jfdoppler/Placa-grabador/guia.pdf

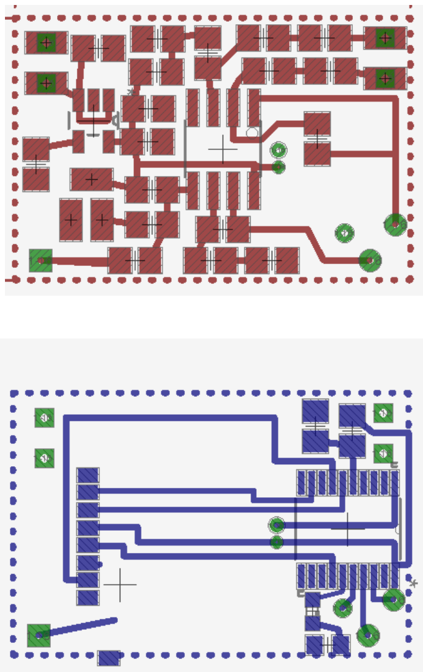
[picture p2: page 1]
