jfdoppler/Placa-grabador/drawing-1.png

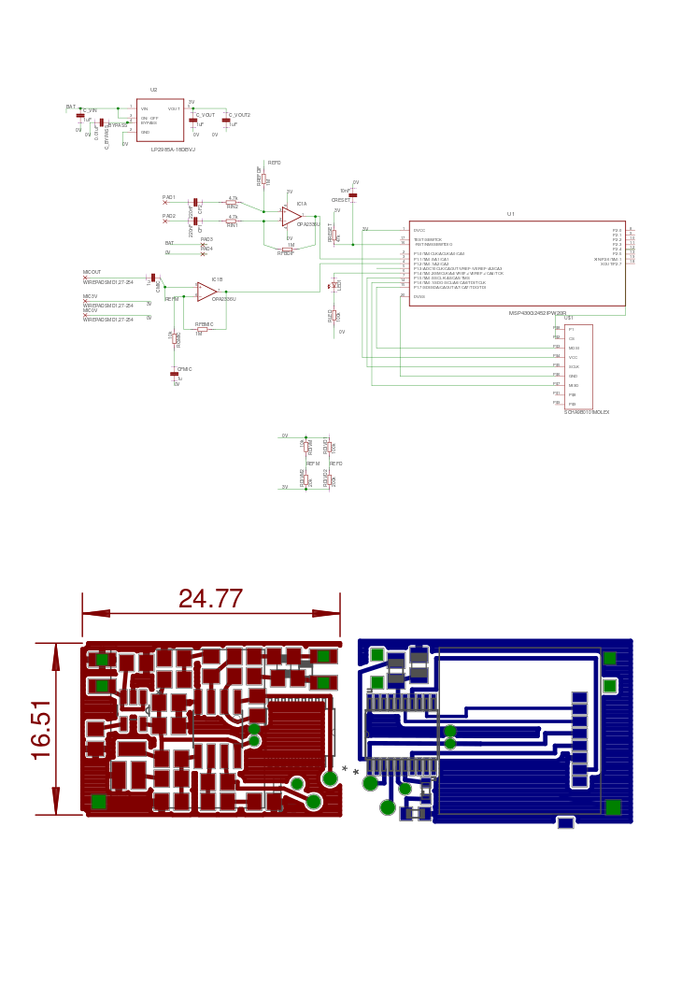
drawing-1.png
