jfdoppler/Placa-grabador/Placa terminada 31082017/20170831_150136.jpg

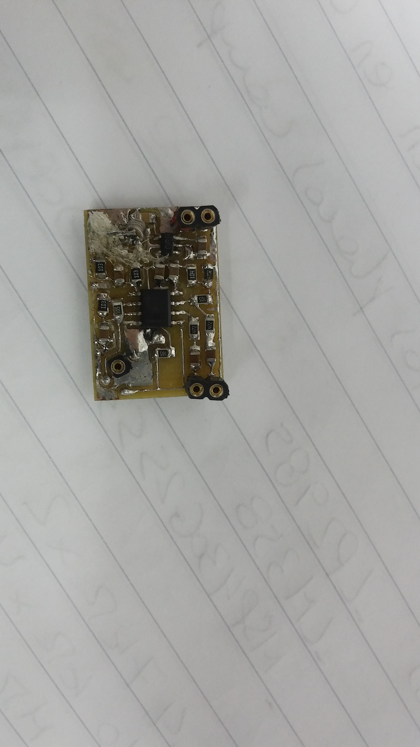
Placa terminada 31082017/20170831_150136.jpg
