jfdoppler/Placa-grabador/v2017.svg.pdf

### OPA2336U

4.7k

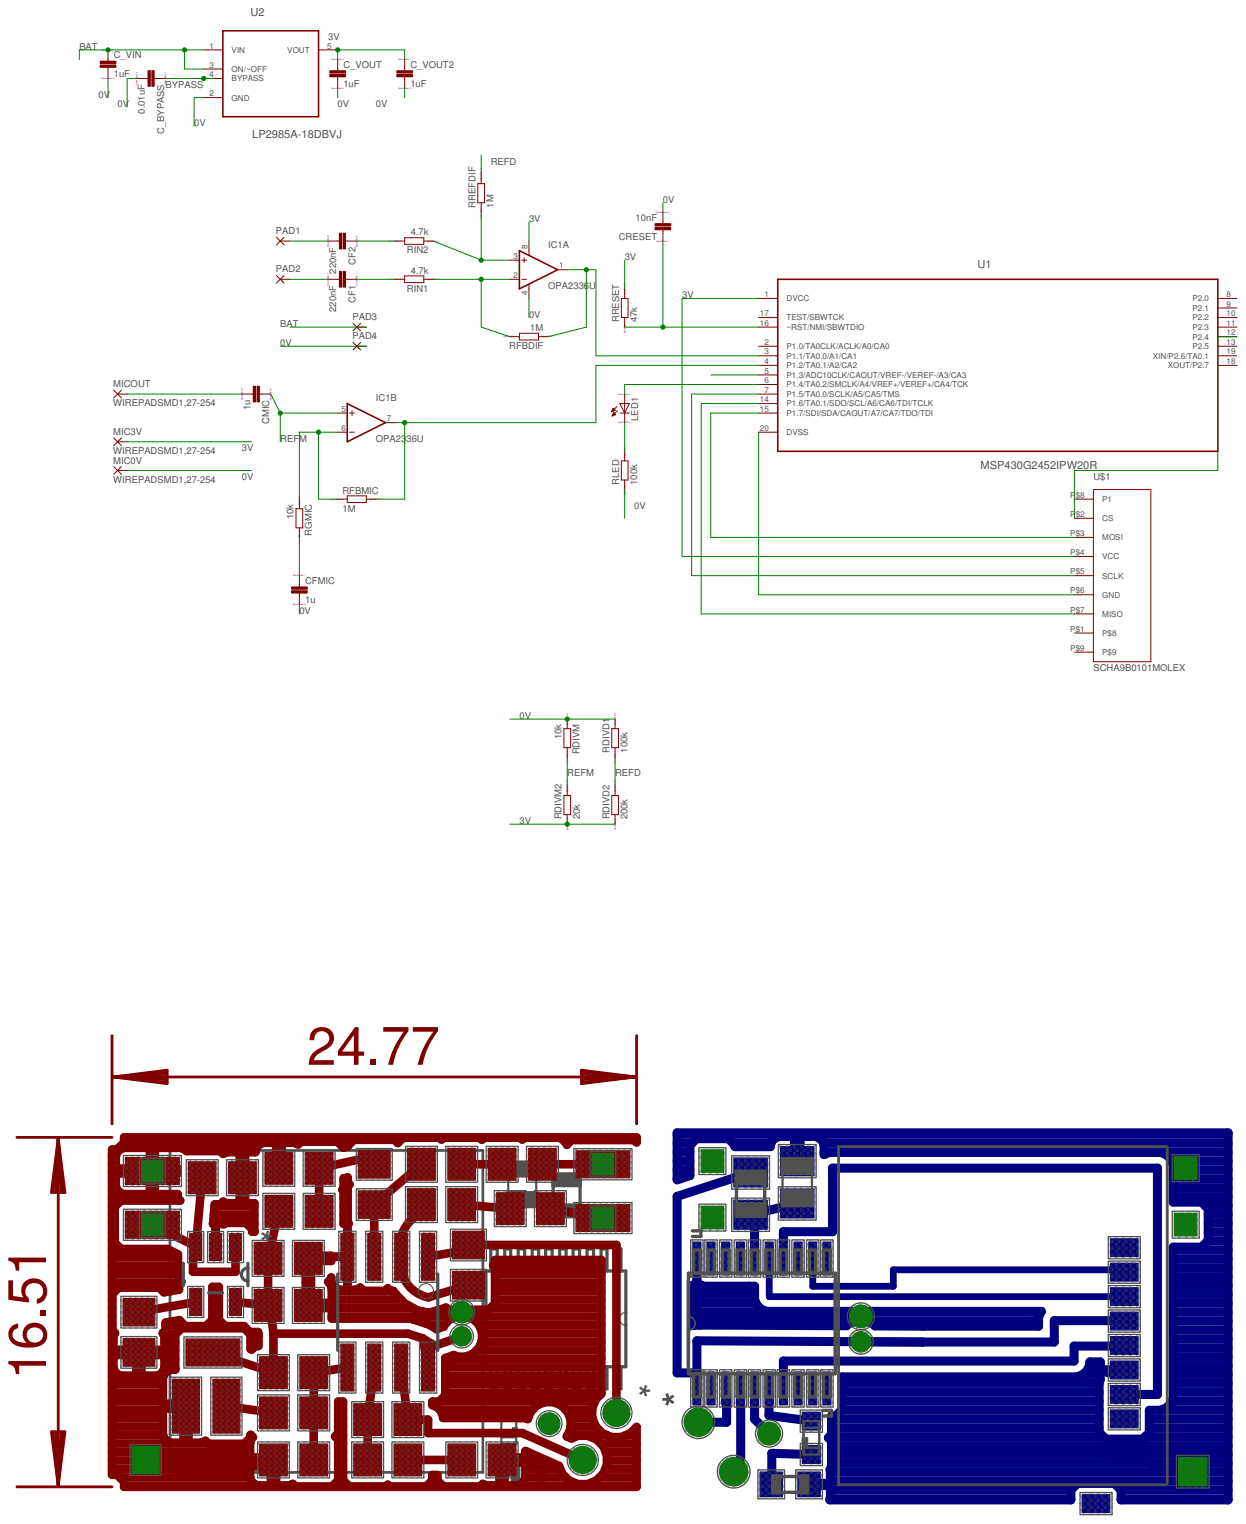
[picture p55: page 1]
SpiceOrder 1 SpiceOrder 2; SpiceOrder 2; SpiceOrder 1; MSP430G2452IPW20R; WIREPADSMD1,27-254; OPA2336U; LP2985A-18DBVJ; RREFDIF; RDIVM; RDIVM2; RGMIC; DVCC 1; P1.0/TA0CLK/ACLK/A0/CA0 2 P1.1/TA0.0/A1/CA1 3 P1.2/TA0.1/A2/CA2 4; DVSS 20; XIN/P2.6/TA0.1; XOUT/P2.7; MIC3V; MICOUT; MIC0V; MOSI P$3; VCC P$4; MISO P$7; SCHA9B0101MOLEX; CMIC; CFMIC; RFBMIC; RDIVD1 RDIVD2; RIN1; RIN2; RFBDIF; VIN 1; ON/~OFF 3 BYPASS 4; GND 2; VOUT; C_BYPASS; C_VIN; C_VOUT; C_VOUT2; LED1; PAD1; PAD2; PAD3; PAD4; REFM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

RLED RRESET CRESET

SpiceOrder 1 SpiceOrder 2

TEST/SBWTCK 17
~RST/NMI/SBWTDIO 16

P1.3/ADC10CLK/CAOUT/VREF-/VEREF-/A3/CA3 5

P1.4/TA0.2/SMCLK/A4/VREF+/VEREF+/CA4/TCK 6

P1.5/TA0.0/SCLK/A5/CA5/TMS 7

P1.6/TA0.1/SDO/SCL/A6/CA6/TDI/TCLK 14
P1.7/SDI/SDA/CAOUT/A7/CA7/TDO/TDI 15

SCLK P$5

GND P$6
