jfdoppler/Placa-grabador/5031821852_sd.pdf

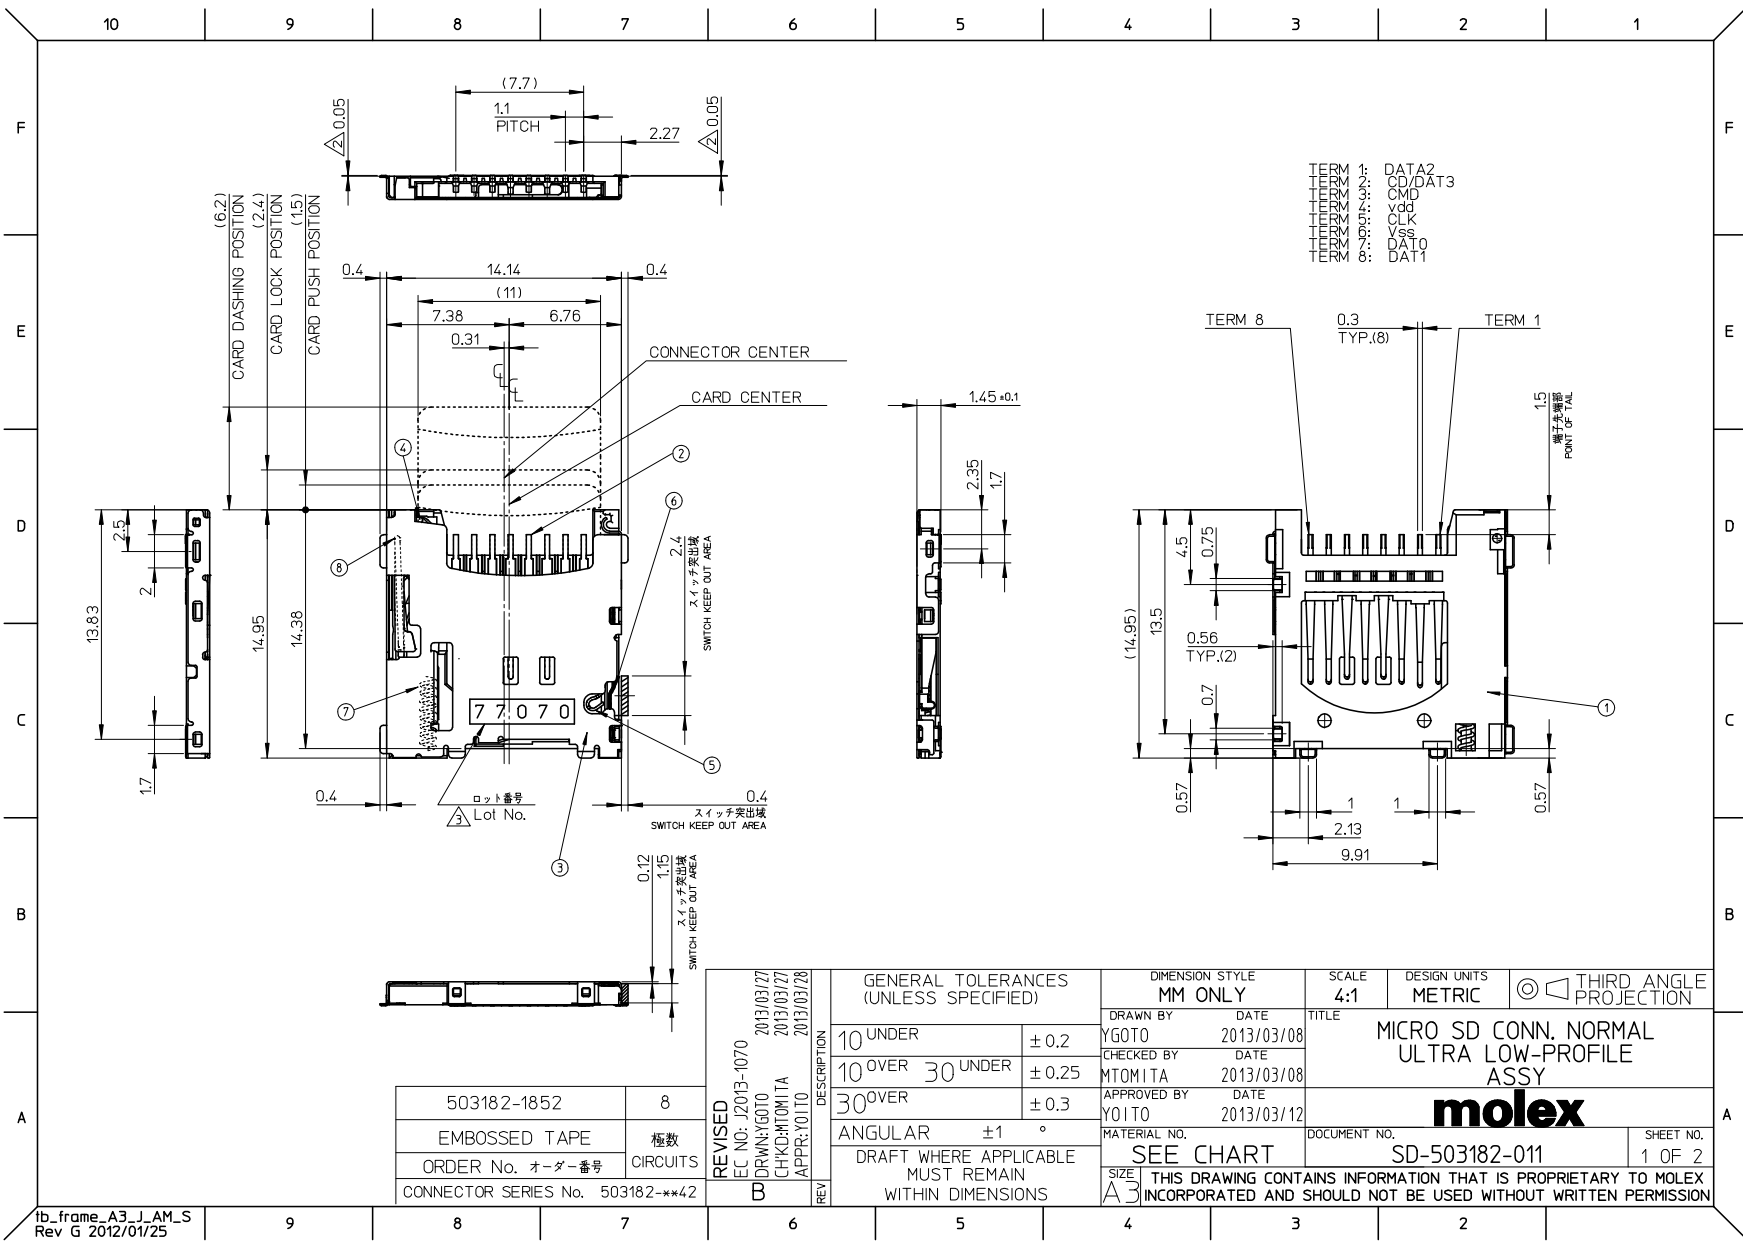
[picture p56: page 1]

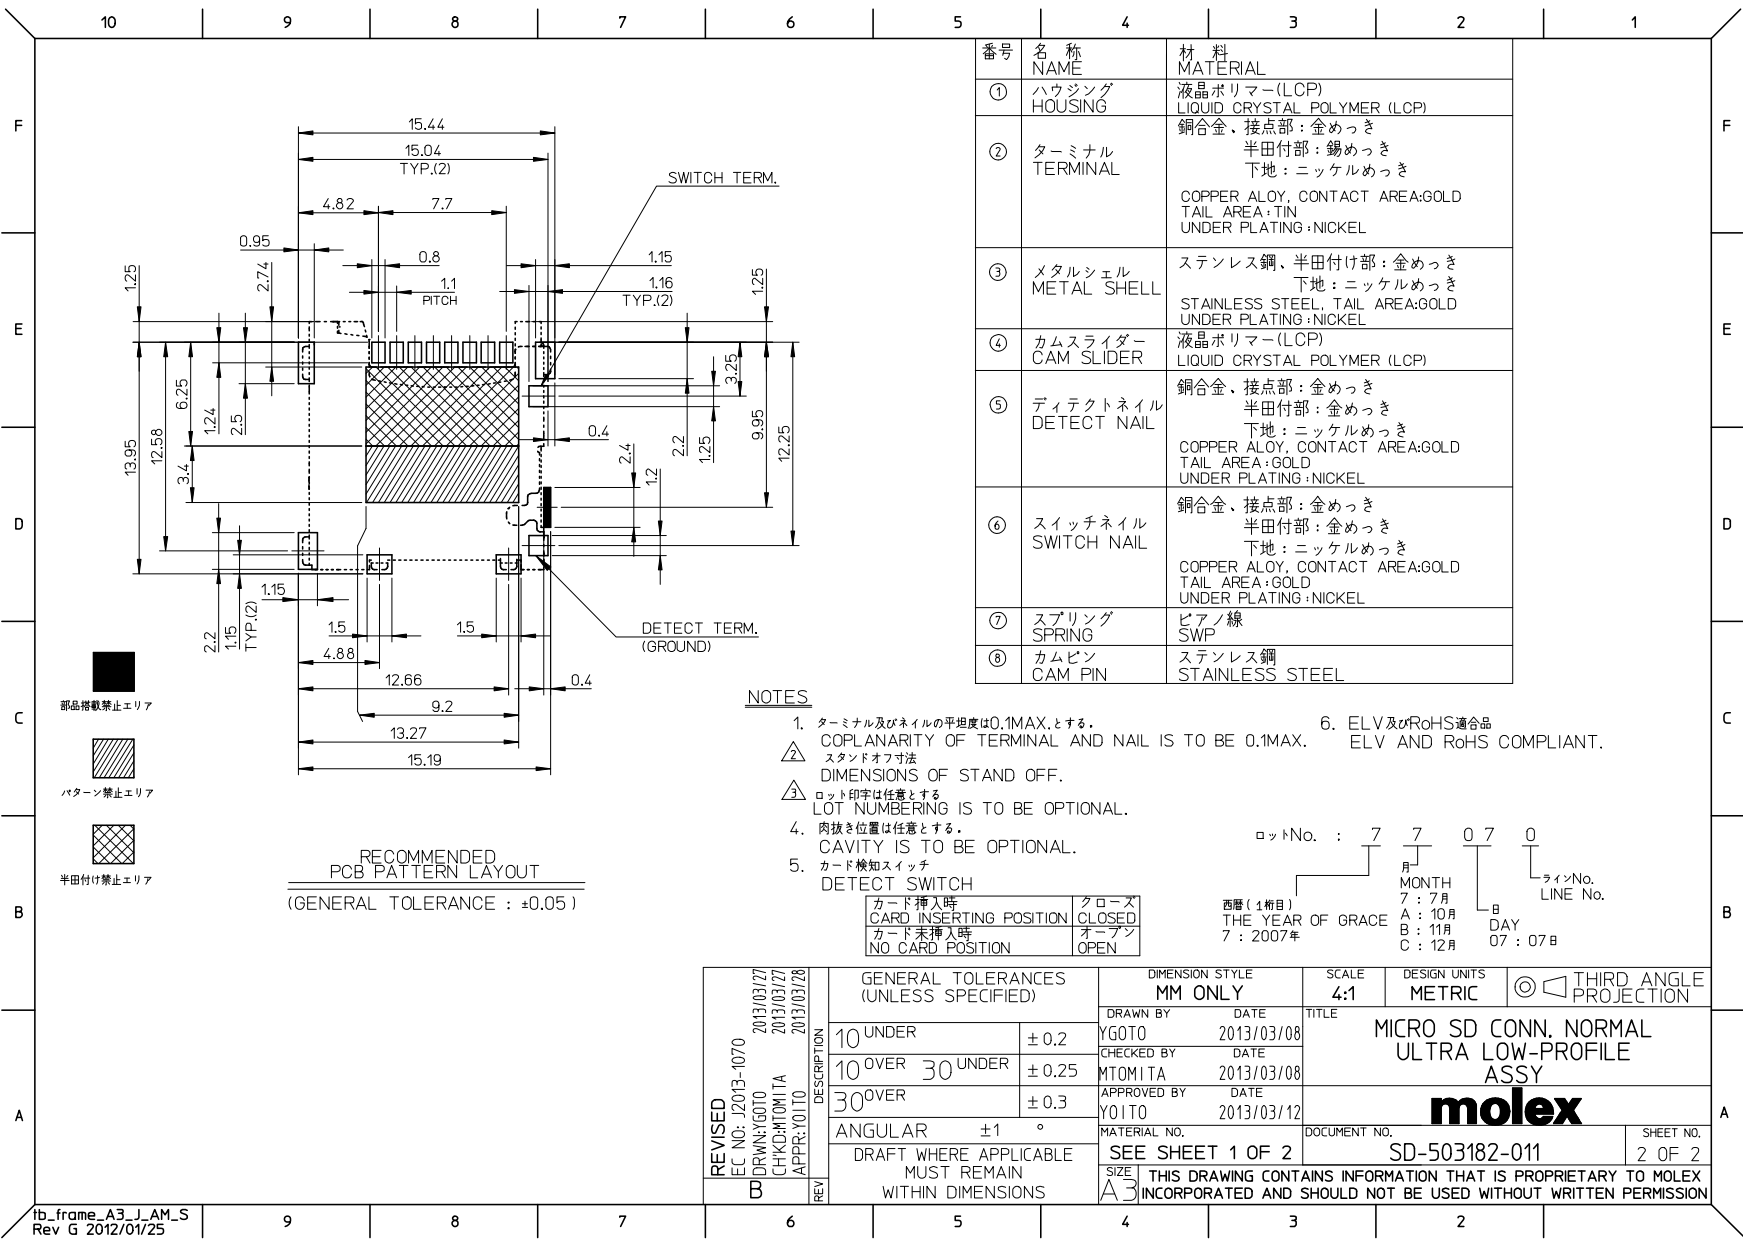
[picture p57: page 2]

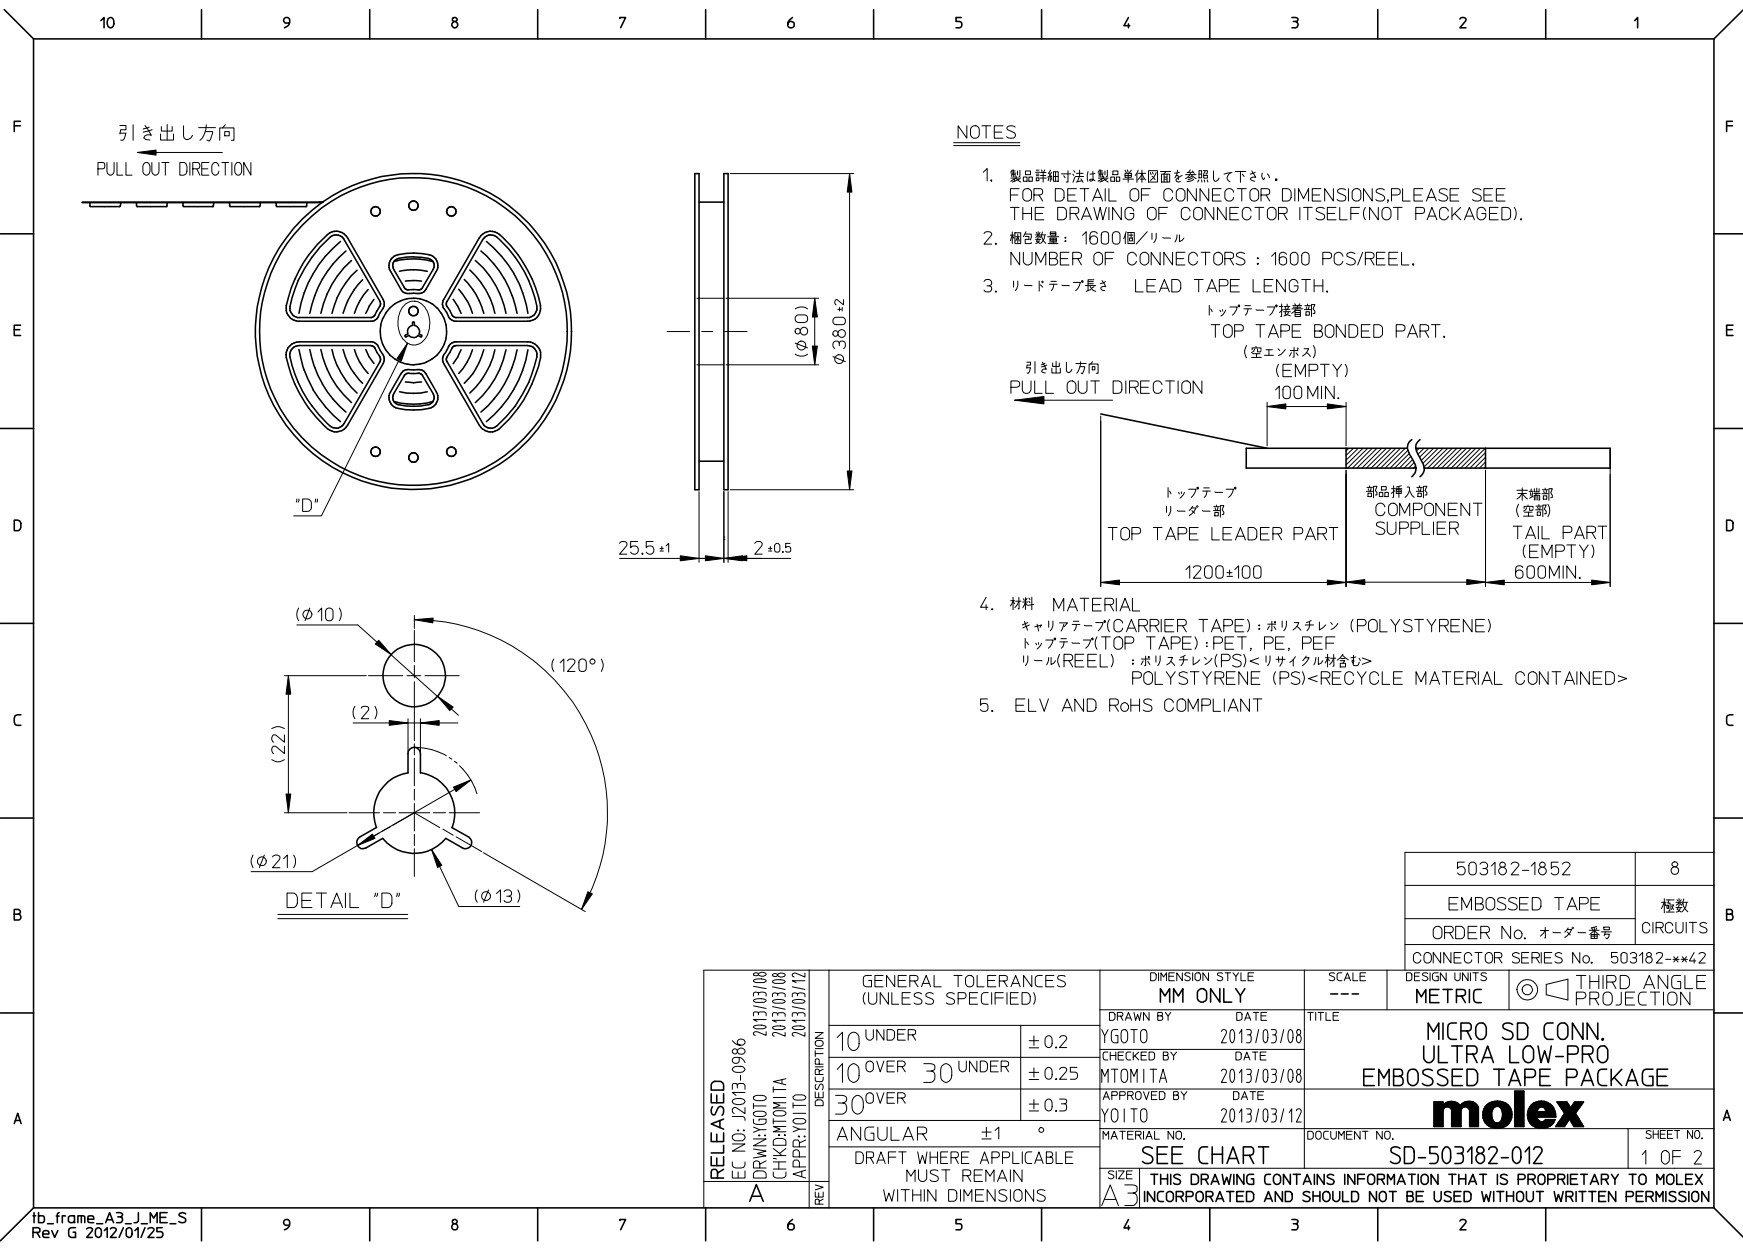
[picture p58: page 3]

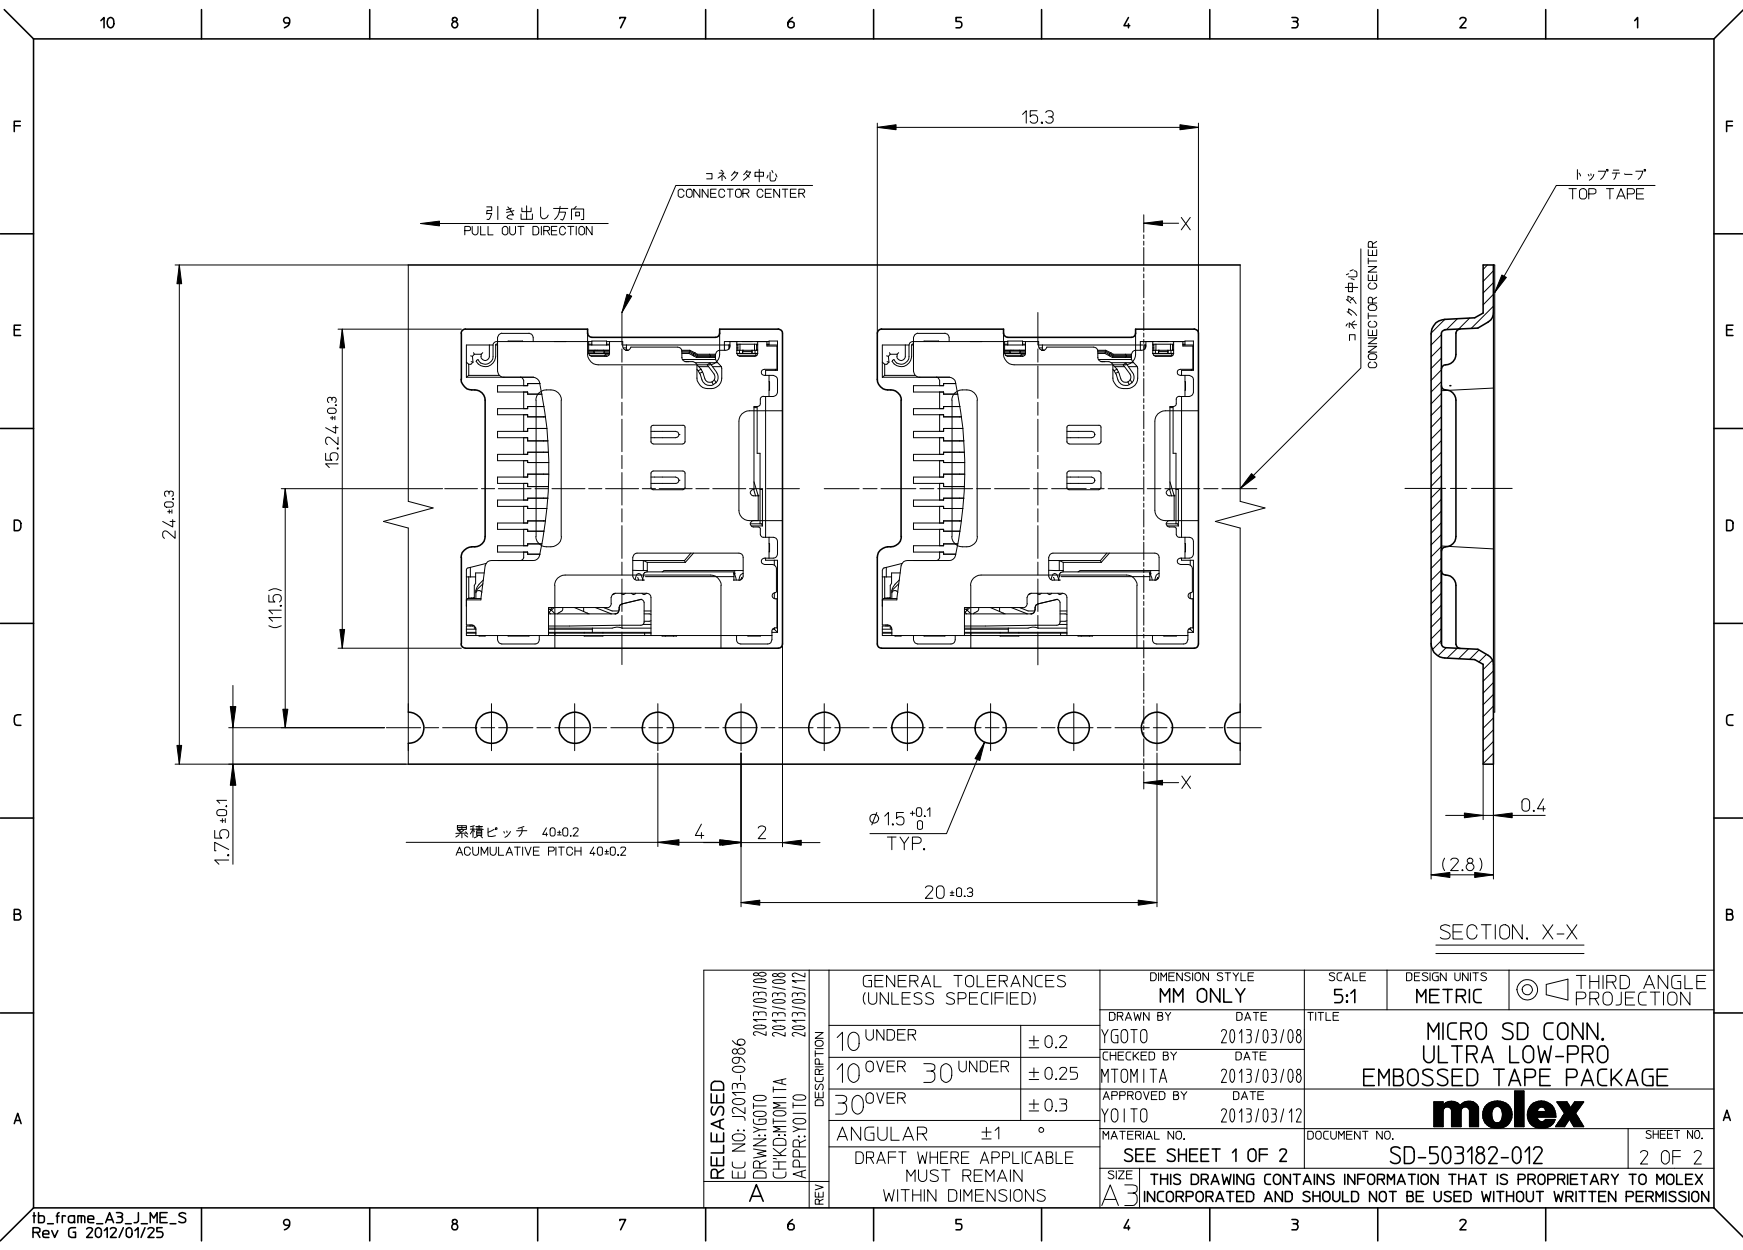
[picture p59: page 4]
