jfdoppler/Placa-grabador/microSD-v2017-bottom.pdf

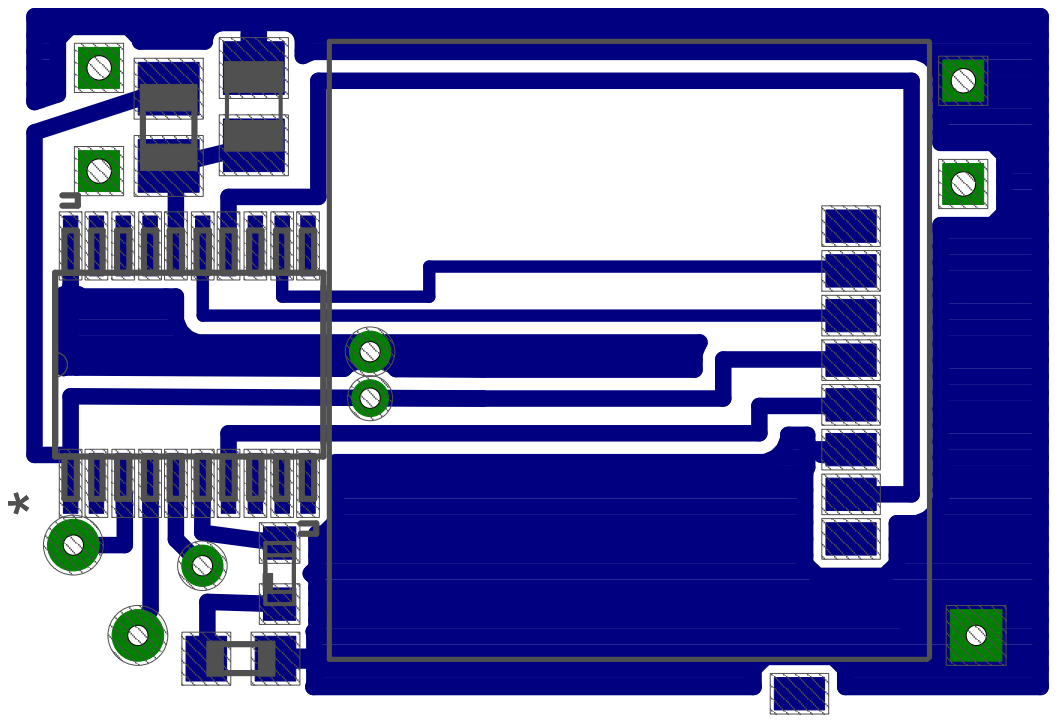
[picture p60: page 1]
