jfdoppler/Placa-grabador/microSD-v2017-esquematico.pdf

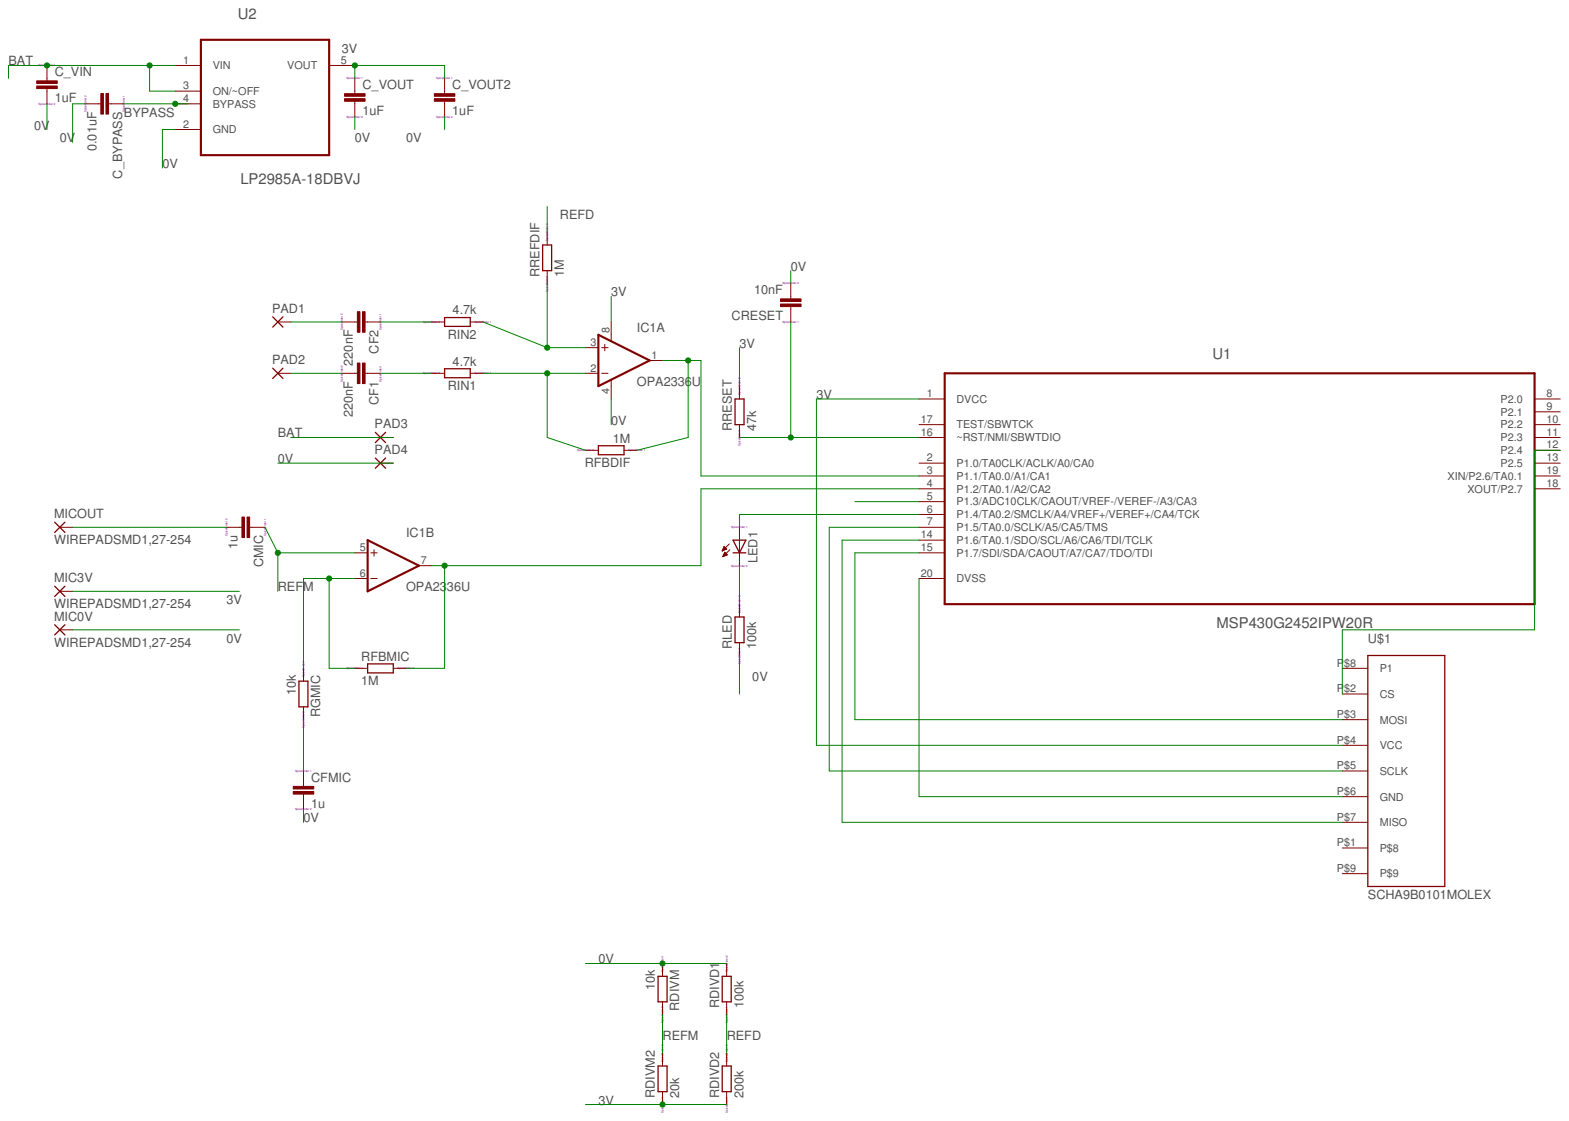
[picture p61: page 1]

SpiceOrder 1 SpiceOrder 2
