jfdoppler/Placa-grabador/microSD-v2017-top.pdf

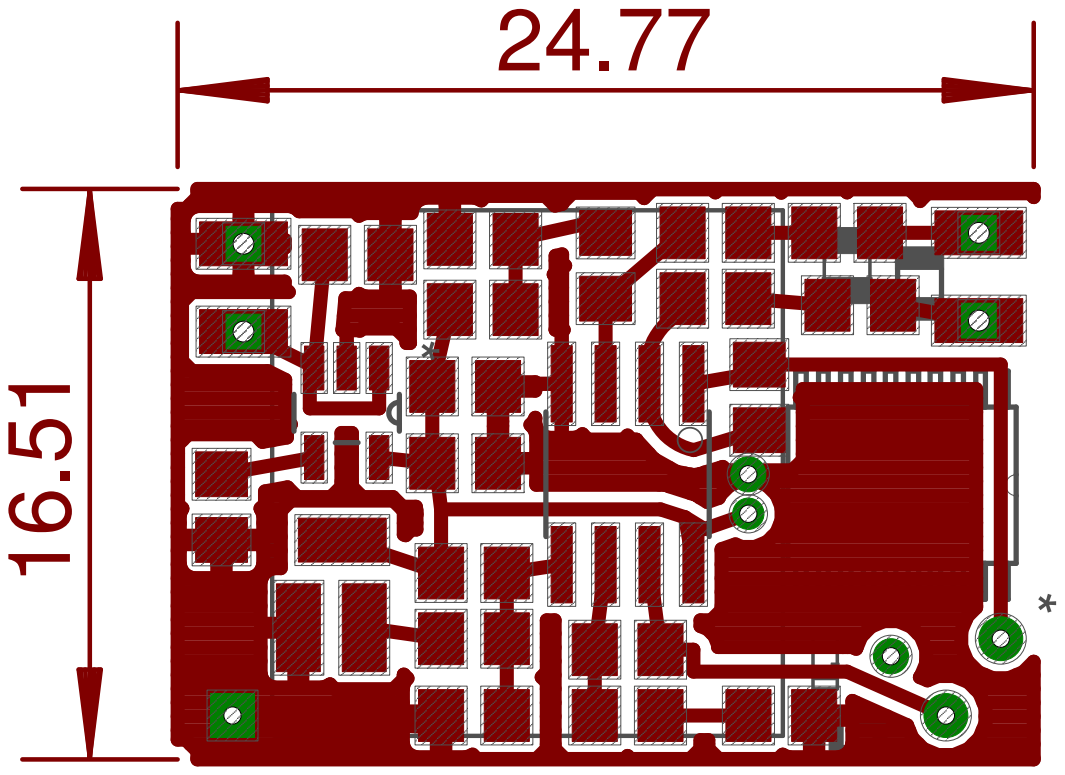
[picture p62: page 1]
