jfdoppler/Placa-grabador/Placa terminada 31082017/calls_grabados.pdf

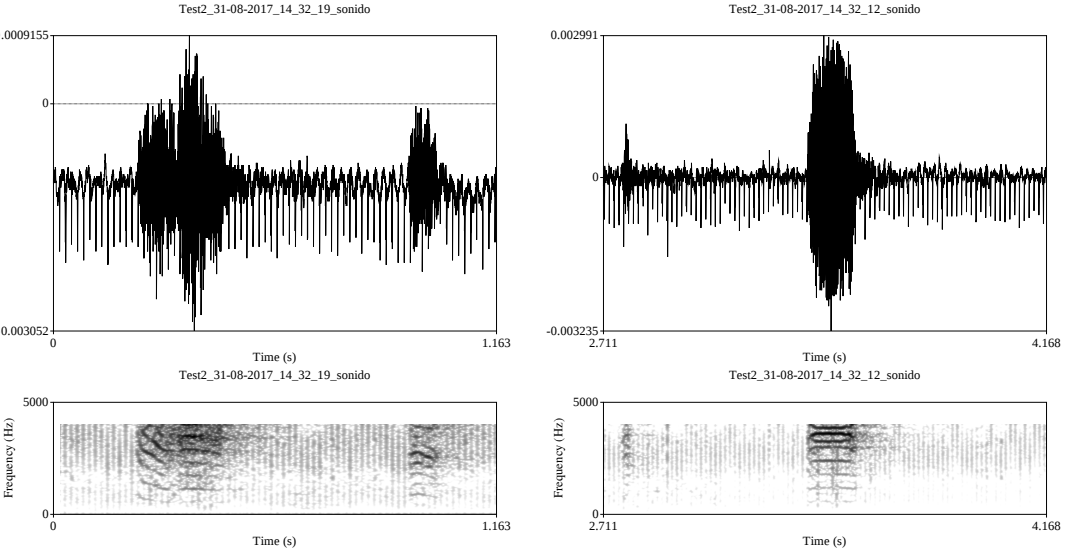
[picture p63: page 1]
Time (s); Test2_31-08-2017_14_32_19_sonido; Frequency (Hz); Test2_31-08-2017_14_32_12_sonido
