jfdoppler/Placa-grabador/microSD-v2017.brd

## EAGLE design microSD-v2017.brd (2019-03-22)

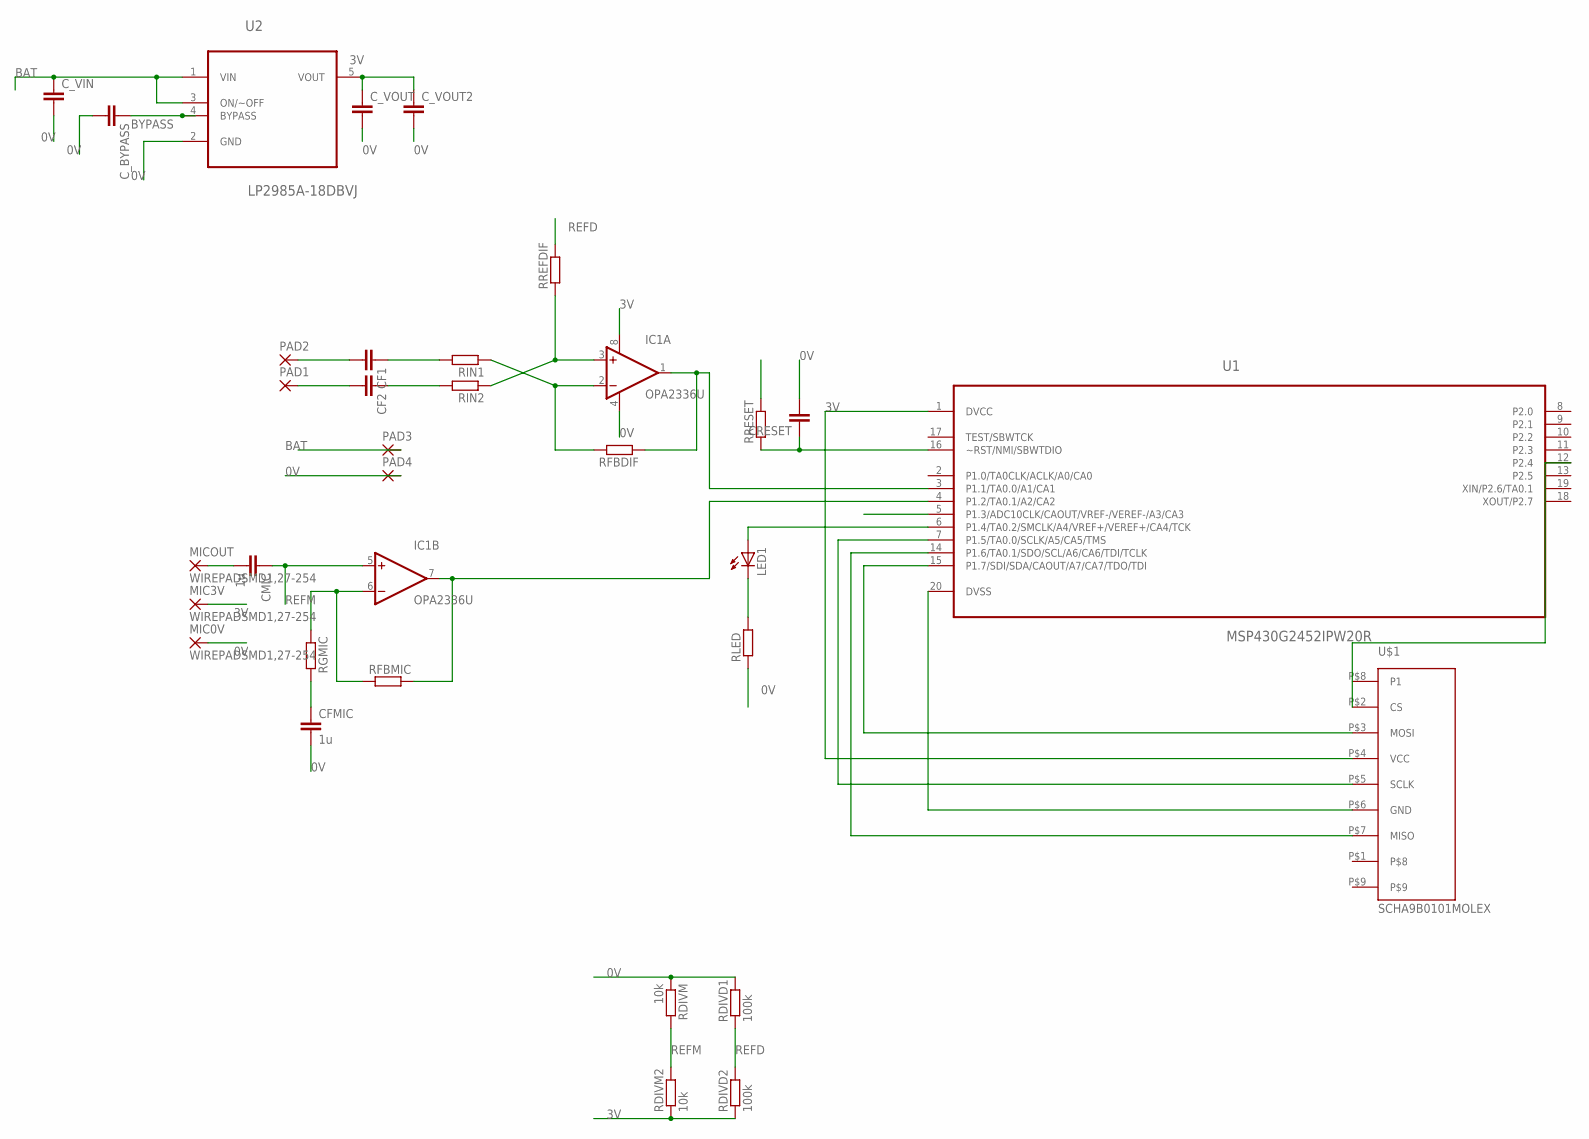
[picture p64: schematic microSD-v2017.sch]

Parts:
CF1, CF2: C; C0805
CFMIC: 1u; C0805
CMIC: 1u; C0805
CRESET: C; C0805
C_BYPASS: C; C0805
C_VIN: C; C0805
C_VOUT, C_VOUT2: C; C0805
IC1: OPA2336U; SO08
LED1: LED_ESML0603; LED_SML0603
MIC0V, MIC3V: WIREPADSMD1,27-254; SMD1,27-2,54
MICOUT: WIREPADSMD1,27-254; SMD1,27-2,54
PAD1, PAD2, PAD3, PAD4: SMD2; SMD1,27-2,54
RDIVD1, RDIVD2: 100k; R0805
RDIVM, RDIVM2: 10k; R0805
RFBDIF: R; R0805
RFBMIC: R; R0805
RGMIC: R; R0805
RIN1, RIN2: R; R0805
RLED: RR0603; R0603
RREFDIF: R; R0805
RRESET: R; R0805
U1: MSP430G2452IPW20R; SOP65P640X120-20N
U2: LP2985A-18DBVJ; SOT95P280X145-5N
U$1: SCHA9B0101MOLEX; SMD-MOLEX

Connections:
0V: CFMIC.2, CRESET.2, C_BYPASS.2, C_VIN.2, C_VOUT.2, C_VOUT2.2, IC1.4 (V-), MIC0V.1, PAD4.1, RDIVD1.2, RDIVM.1, RLED.1, U1.20 (DVSS), U2.2 (GND), U$1.P$6 (GND)
3V: C_VOUT.1, C_VOUT2.1, IC1.8 (V+), MIC3V.1, RDIVD2.1, RDIVM2.1, RRESET.2, U1.1 (DVCC), U2.5 (VOUT), U$1.P$4 (VCC)
BAT: C_VIN.1, PAD3.1, U2.1 (VIN), U2.3 (ON/~OFF)
BYPASS: C_BYPASS.1, U2.4 (BYPASS)
LED: LED1.A, U1.6 (P1.4/TA0.2/SMCLK/A4/VREF+/VEREF+/CA4/TCK)
unnamed: CF1.1, RIN1.2
unnamed: CF2.1, RIN2.2
unnamed: IC1.3 (+IN), RIN2.1, RREFDIF.1
unnamed: CRESET.1, RRESET.1, U1.16 (~RST/NMI/SBWTDIO)
unnamed: CF1.2, PAD2.1
unnamed: CF2.2, PAD1.1
unnamed: LED1.C, RLED.2
unnamed: CMIC.2, MICOUT.1
unnamed: U1.7 (P1.5/TA0.0/SCLK/A5/CA5/TMS), U$1.P$5 (SCLK)
unnamed: IC1.2 (-IN), RFBDIF.2, RIN1.1
unnamed: U1.14 (P1.6/TA0.1/SDO/SCL/A6/CA6/TDI/TCLK), U$1.P$7 (MISO)
unnamed: U1.15 (P1.7/SDI/SDA/CAOUT/A7/CA7/TDO/TDI), U$1.P$3 (MOSI)
unnamed: U1.12 (P2.4), U$1.P$2 (CS)
unnamed: IC1.6 (-IN), RFBMIC.1, RGMIC.1
unnamed: CFMIC.1, RGMIC.2
OUTDIF: IC1.1 (OUT), RFBDIF.1, U1.3 (P1.1/TA0.0/A1/CA1)
OUTMIC: IC1.7 (OUT), RFBMIC.2, U1.4 (P1.2/TA0.1/A2/CA2)
REFD: RDIVD1.1, RDIVD2.2, RREFDIF.2
REFM: CMIC.1, IC1.5 (+IN), RDIVM.2, RDIVM2.2

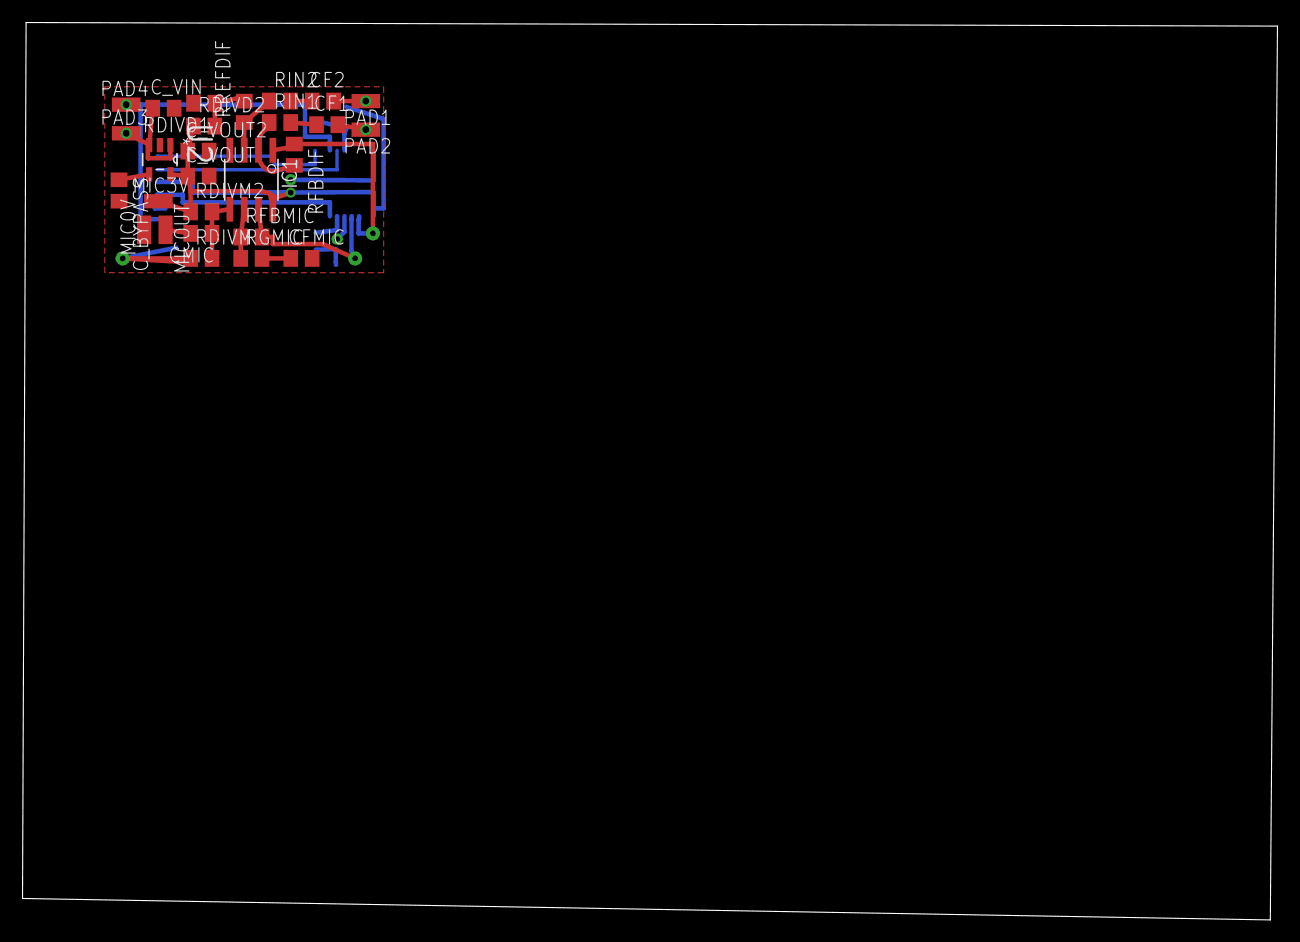
[picture p65: board microSD-v2017.brd from above]

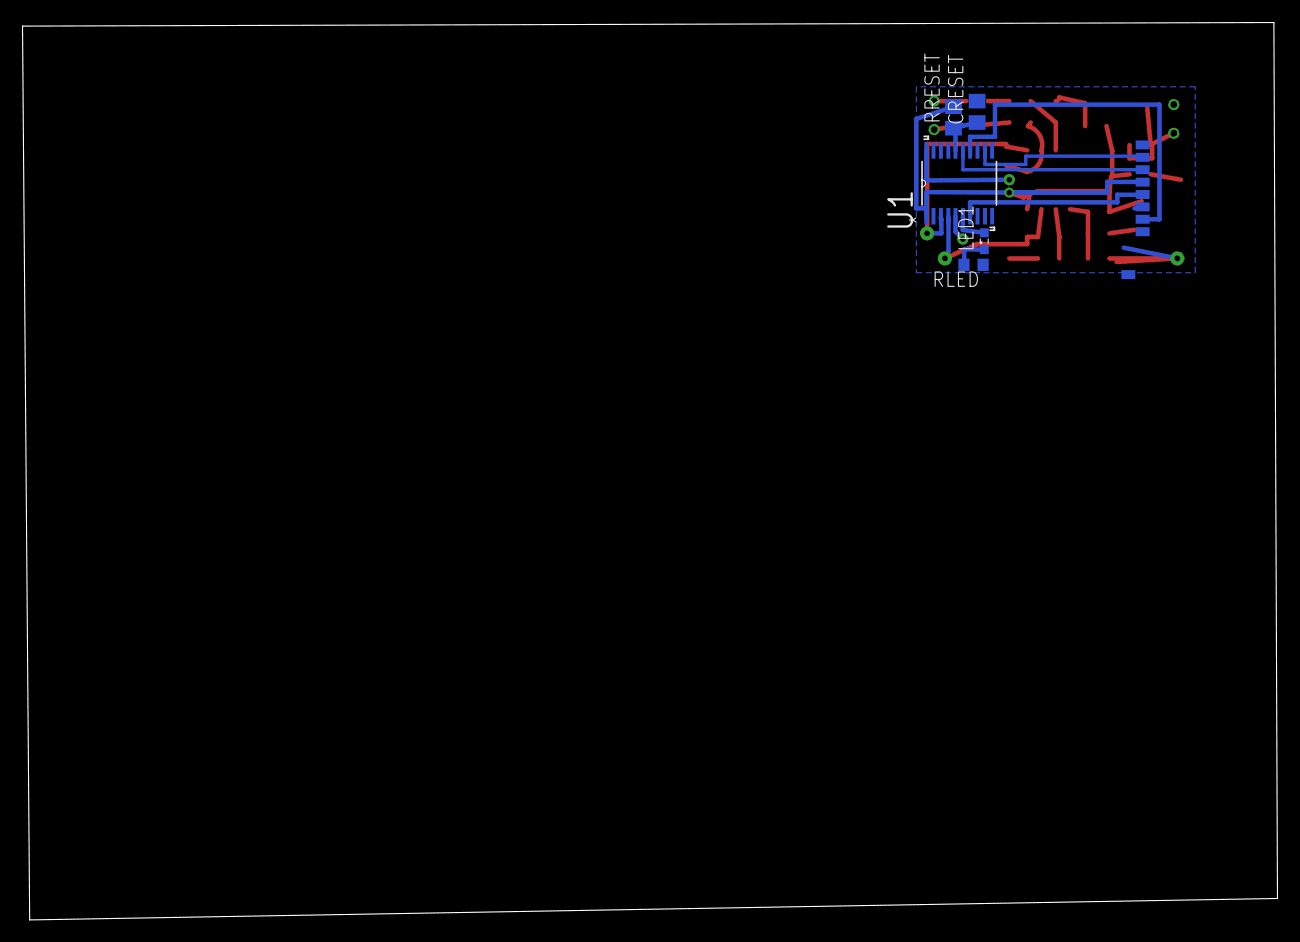
[picture p66: board microSD-v2017.brd from below]

Board: 2 copper layers, 111.4 x 79.7 mm, 33 parts (6 on the bottom side), 24 nets.
